evandro-teixeira/TCC---Otimiza-o-de-um-Refrigerador-Cycle-Defrost/Documentos/Imagens/2013-10-01_13-03-01_952.jpg

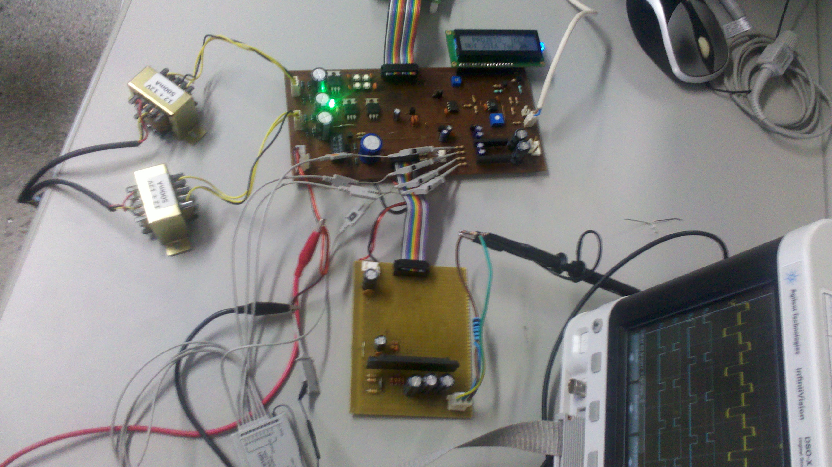
Documentos/Imagens/2013-10-01_13-03-01_952.jpg
