evandro-teixeira/TCC---Otimiza-o-de-um-Refrigerador-Cycle-Defrost/Documentos/Imagens/2013-10-01_13-02-46_918.jpg

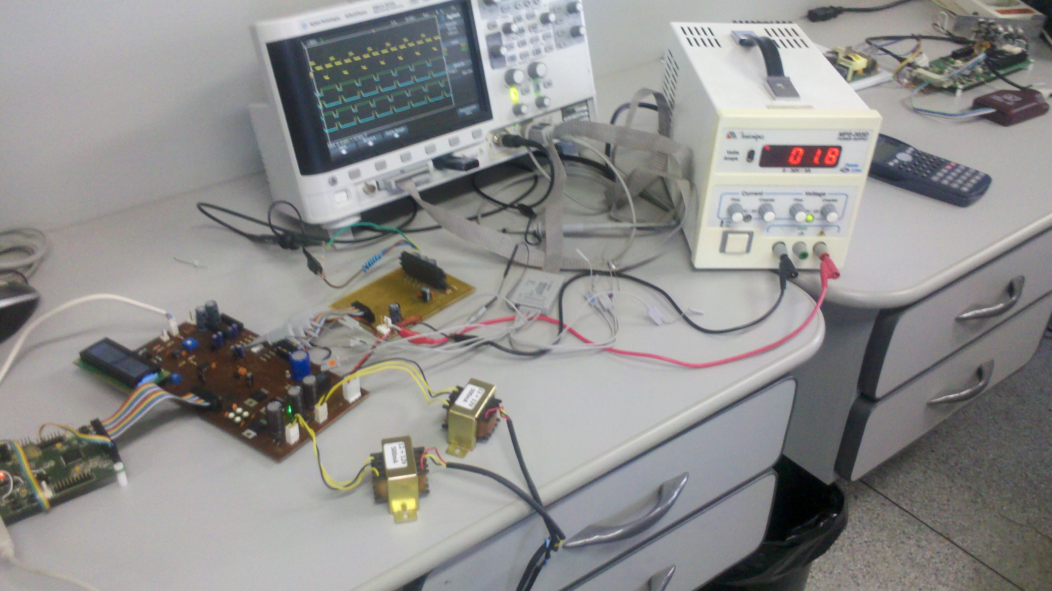
Documentos/Imagens/2013-10-01_13-02-46_918.jpg
