evandro-teixeira/TCC---Otimiza-o-de-um-Refrigerador-Cycle-Defrost/README.md

# TCC "Otimização de um Refrigerador Cycle Defrost"

Os refrigeradores domésticos convencionais apresentam um sistema de funcionamento singularmente simples, onde uma temperatura de operação é selecionada e um termostato é responsável por desativar o circuito elétrico de alimentação do motor do compressor, no momento em que essa temperatura é atingida internamente. Após o aumento da temperatura interna do refrigerador, novamente o compressor é acionado refrigerando seu interior até a temperatura selecionada, gerando um ciclo.

Apesar de esse sistema ser funcional, o mesmo apresenta algumas características negativas. Entre elas está o alto consumo de energia elétrica proveniente dos picos de corrente oriundos do acionamento do compressor.

Esse Trabalho de Conclusão de Curso propõe implementar um sistema de controle mais eficiente para o funcionamento do refrigerador através de um hardware e um software desenvolvidos para minimizar os picos de corrente do compressor, controlando sua partida e determinado sua velocidade de rotação pelo monitoramento da temperatura interna do refrigerador.

Em seguida através de testes, pretende-se comprovar o objetivo do projeto: verificar se há redução no consumo de energia com o novo sistema empregado.

Atualmente, apenas os refrigeradores de alto custo possuem esse sistema de controle. Entretanto ele será introduzido no refrigerador Cycle Defrost, um modelo de refrigerador mais simples e de baixo custo.

O trabalho de Conclusão de Curso realizado por:

EvandroTeixeira, Gerson Cezar Stein Junior, Guilherme Martino.

Orientado pelo Professor Marcus Vinícius Ataíde
