evandro-teixeira/TCC---Otimiza-o-de-um-Refrigerador-Cycle-Defrost/Documentos/Apresentação_TCC.pdf.pdf

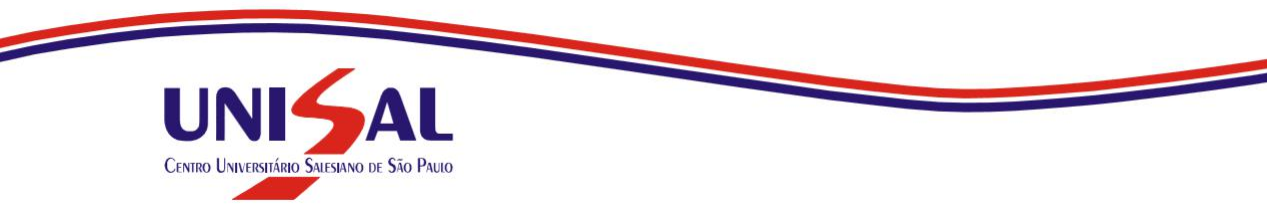
[picture p14: figure]

## Otimização de um Refrigerador Cycle Defrost

UNIVERSIDADE SALESIANA DE SÃO PAULO ENGENHARIA ELÉTRICA

Orientador: Professor Marcus Vinícius Ataíde

Evandro Luis Silva Teixeira Gerson Cezar Stein Junior
Guilherme Martino

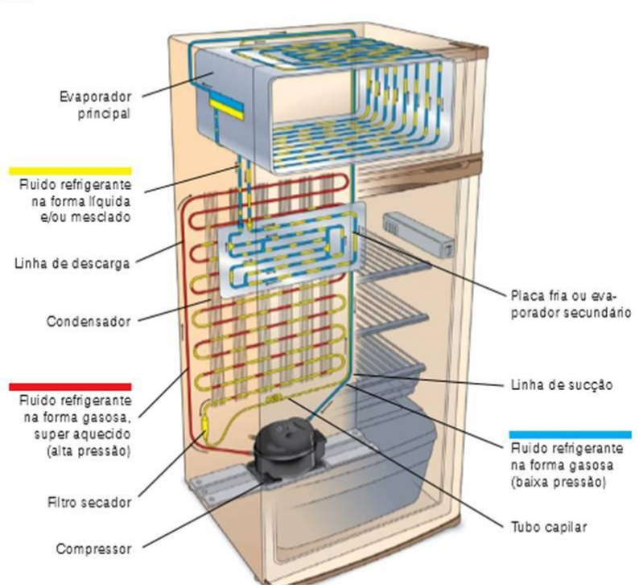
[picture p15: figure]

## Introdução

Funcionamento
do
Refrigerador

## Objetivos

SISTEMA ON-OFF

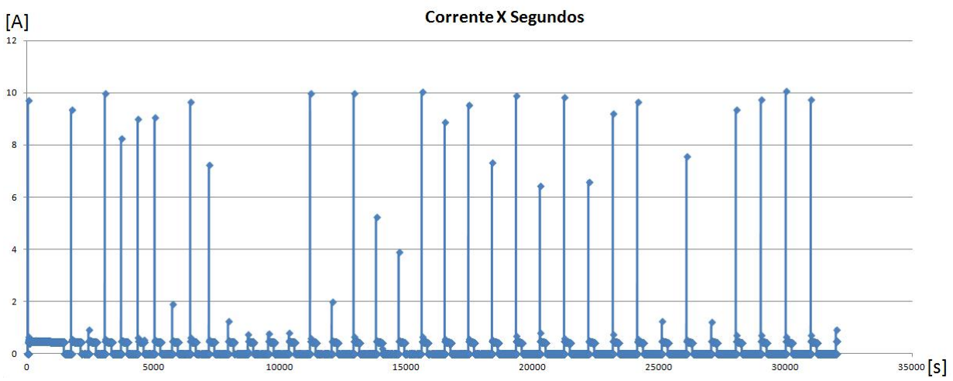
[picture p16: figure]

## Objetivos

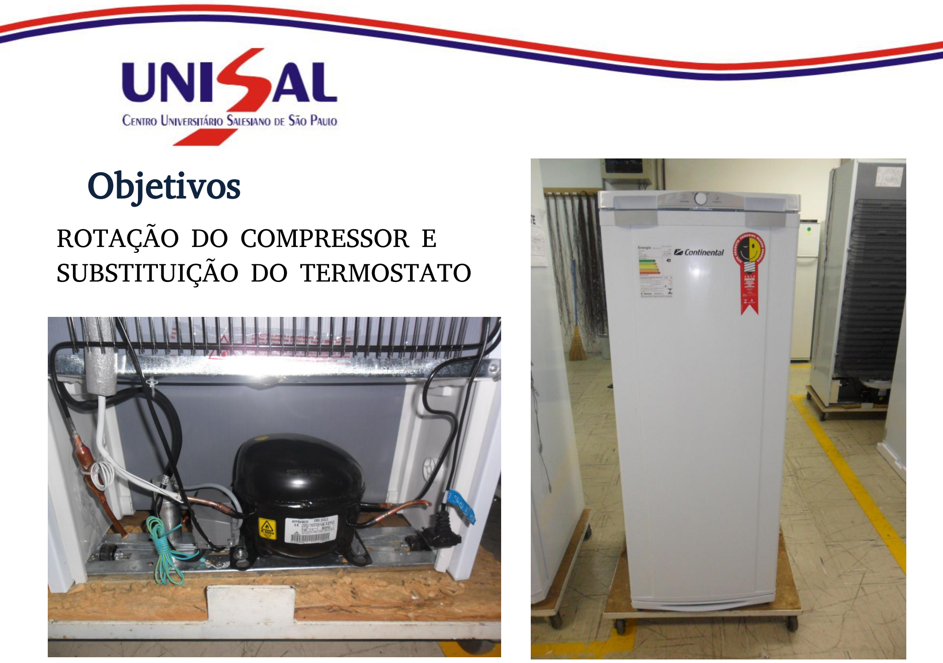
[picture p17: page 4]

ROTAÇÃO DO COMPRESSOR E
SUBSTITUIÇÃO DO TERMOSTATO

## Objetivos

O Projeto:
- Desenvolver o Hardware
- Desenvolver o Software

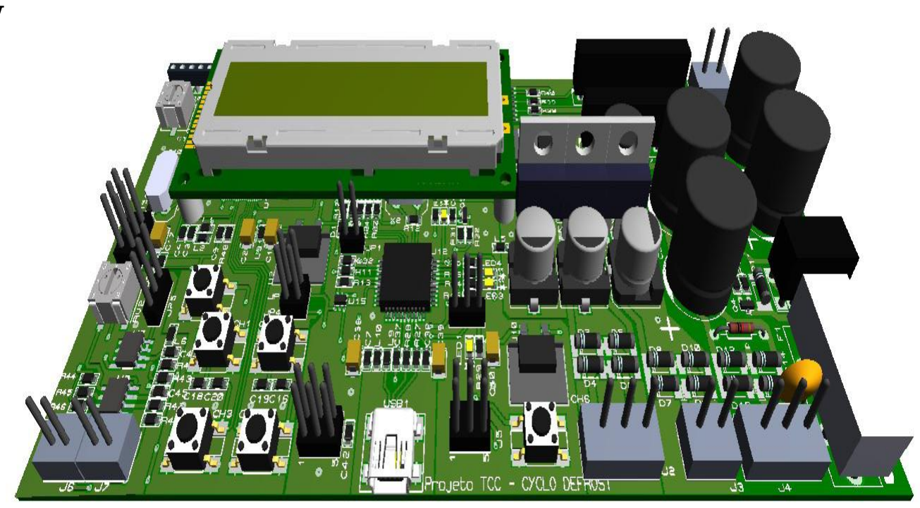
[picture p18: figure]

## Testes Iniciais

MAPEAMENTO DAS TEMPERATURAS INTERNAS DO REFRIGERADOR

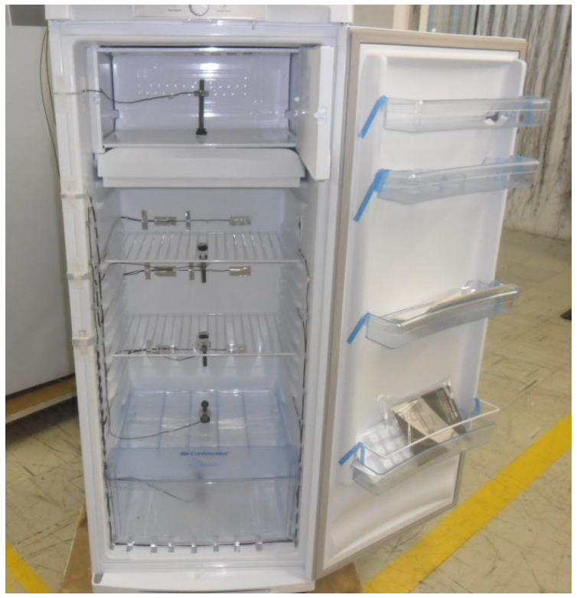
[picture p19: figure]

## Testes Iniciais

ENSAIO DE CONSUMO ENERGÉTICO

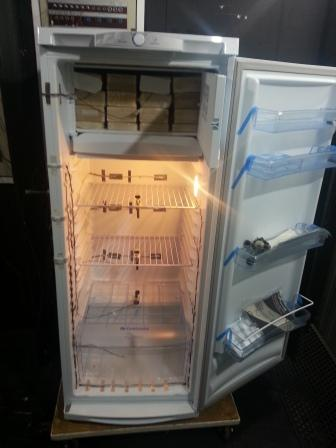
[picture p20: figure]

## Desenvolvimento do Hardware

- Microcontrolador
MCF51MM256
CodeFire 32 bit, 50MHz, ADC 16 bit, DAC 12 bit, 4 Timer PWM
MC9S08JM60

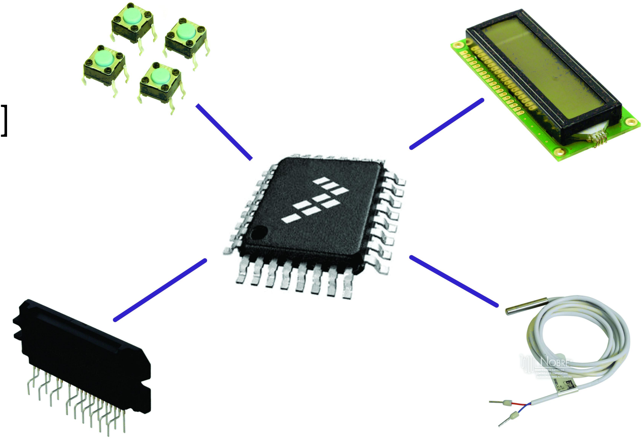
[picture p21: figure]

Circuito de Gravação e Depuração - OSBDM

- IHM
Display LCD 16x2, 4 Push-Button
- Transdutor de Temperatura
Divisor de Tensão, Buffer LT1013, Termistor NTC

## Desenvolvimento do Hardware

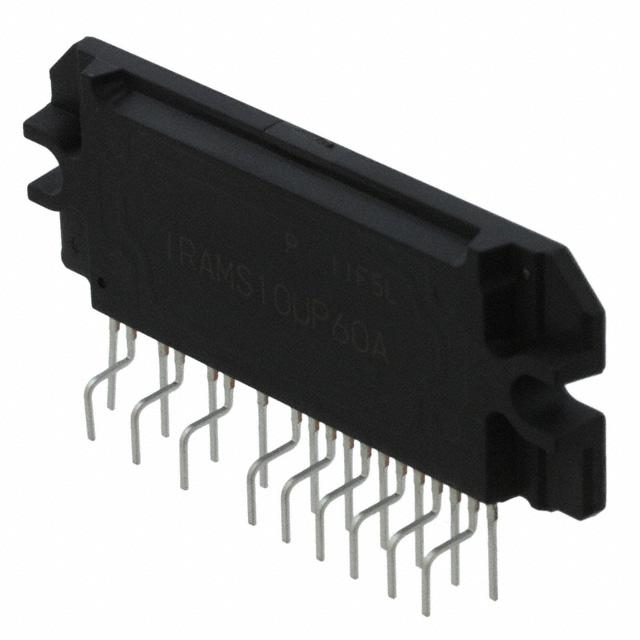
[picture p22: figure]

## Inversor de Frequência

- FSB50250
500V RMS, 1A, 1500V RMS
- IRAMS10P60A
600V RSM, 10A, 2000V RMS
- IR3101
500V RMS, 1.6A, 1500V RMS

## Desenvolvimento do Software

## - Linguagem C - IDE CodeWarrior

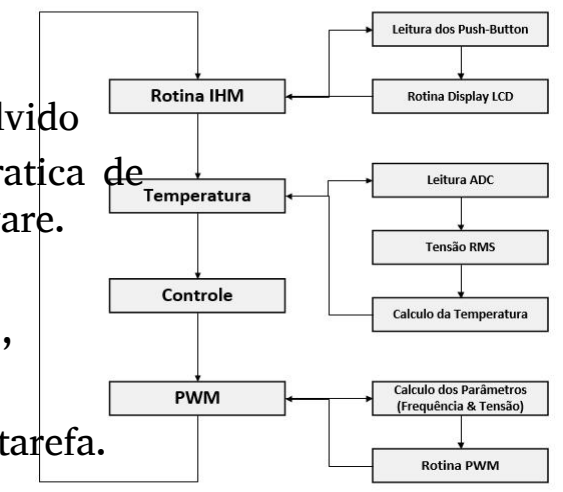
[picture p23: figure]

## - O software foi desenvolvido utilizando as boas pratica de

desenvolvimento Firmware. • Maquina de estado,

- Estruturado em Modulo,

## onde cada modulo é

responsável por uma tarefa.

## Resultados

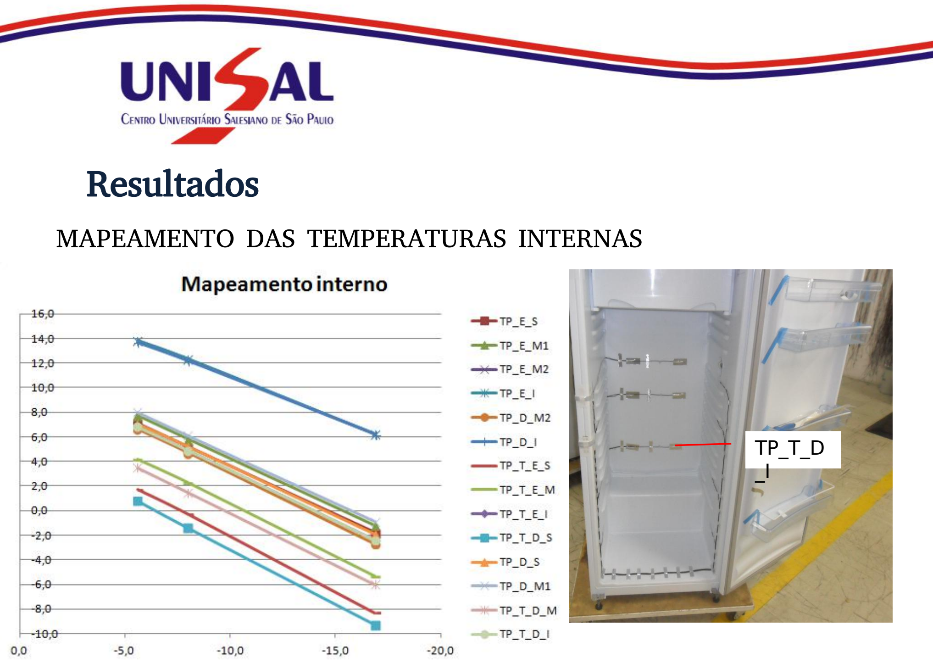
[picture p24: page 11]

MAPEAMENTO DAS TEMPERATURAS INTERNAS

TP_T_D
_I

Resultados CONSUMO | #2 | #3

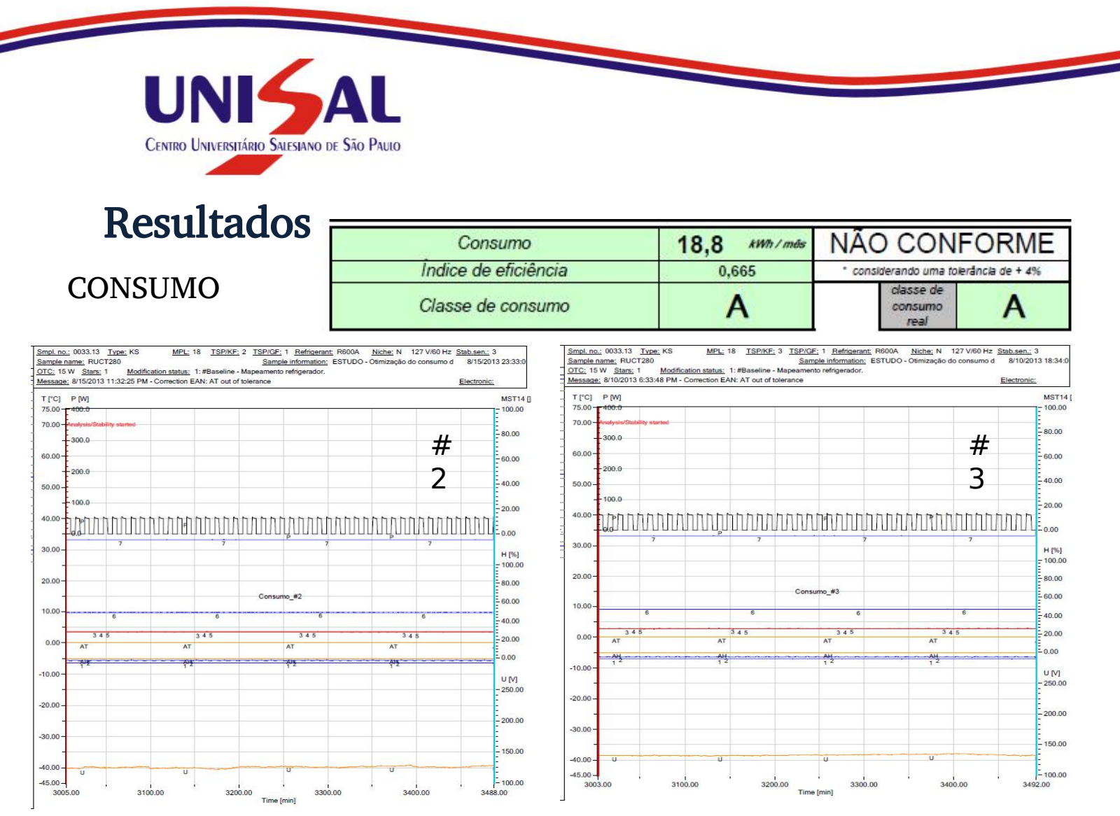
[picture p25: page 12]

## Resultados

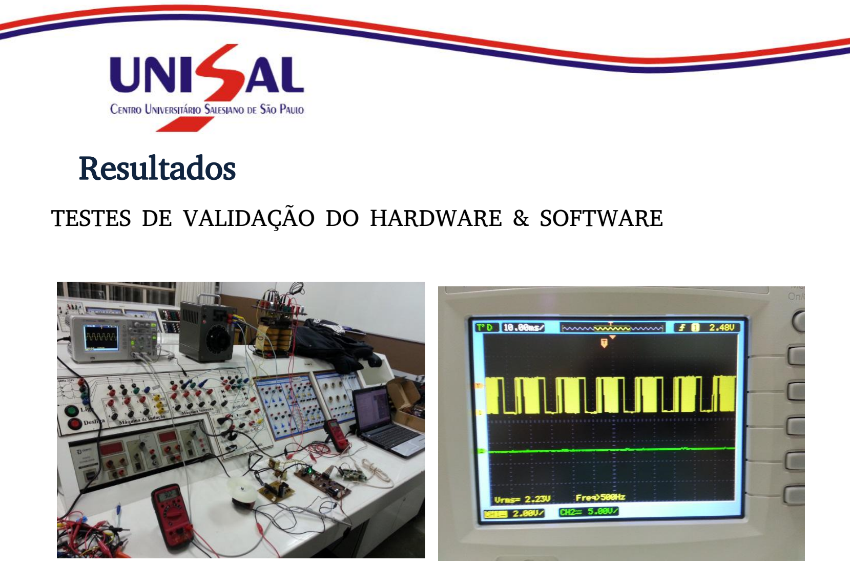
[picture p26: page 13]

TESTES DE VALIDAÇÃO DO HARDWARE & SOFTWARE

## Resultados

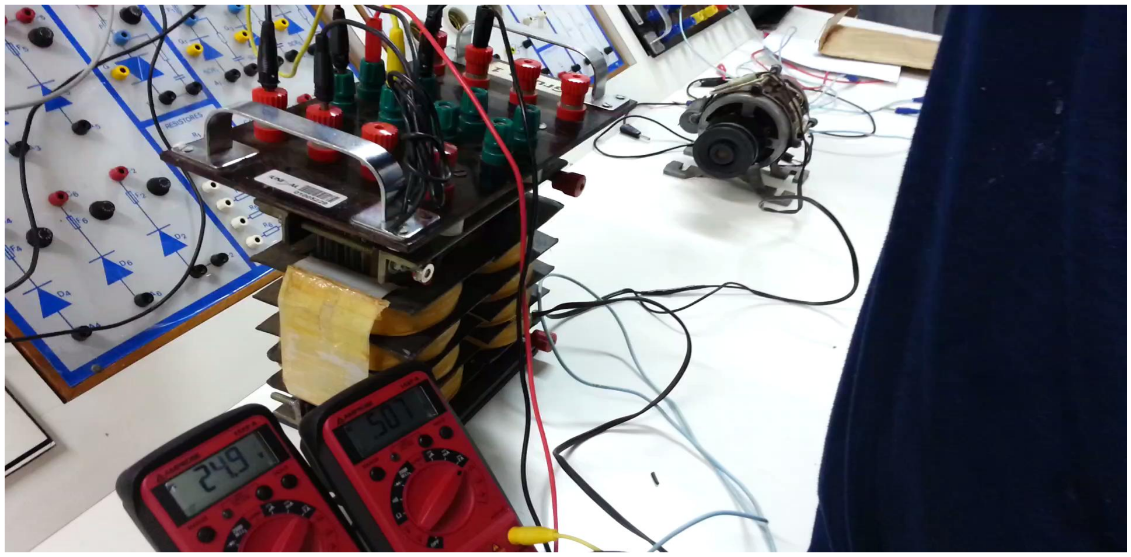
[picture p27: figure]

## Conclusão

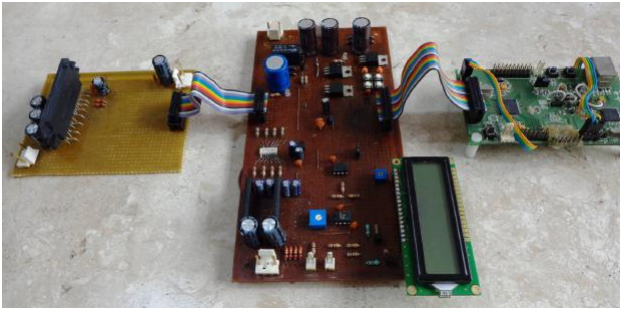
[picture p28: figure]

CUSTO DOS COMPONENTES: $56,73 PARA LOTE DE 1000 UNIDADES

## Agradecimentos

- Primeiramente a Deus por nos ter dado condição e sabedoria. • As empresas MABE, BIOSENSOR e o Centro Universitário

Salesiano de São Paulo nos ter fornecido por todo o material necessário para o desenvolvimento do projeto. Muito Obrigado!
