evandro-teixeira/TCC---Otimiza-o-de-um-Refrigerador-Cycle-Defrost/Documentos/Imagens/2013-10-01_13-02-21_155.jpg

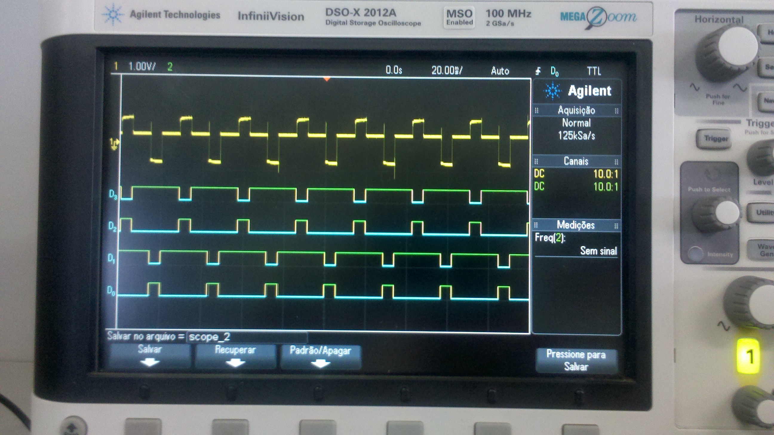
Documentos/Imagens/2013-10-01_13-02-21_155.jpg
