evandro-teixeira/TCC---Otimiza-o-de-um-Refrigerador-Cycle-Defrost/Documentos/Imagens/INV0.jpg

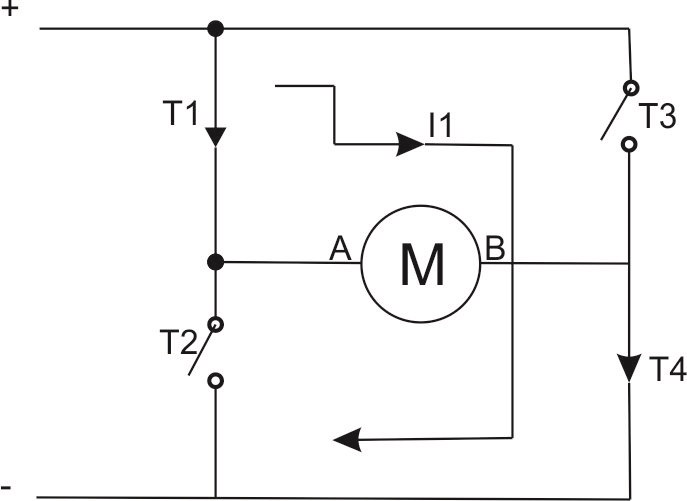
Documentos/Imagens/INV0.jpg
