evandro-teixeira/TCC---Otimiza-o-de-um-Refrigerador-Cycle-Defrost/Documentos/Imagens/INV1.jpg

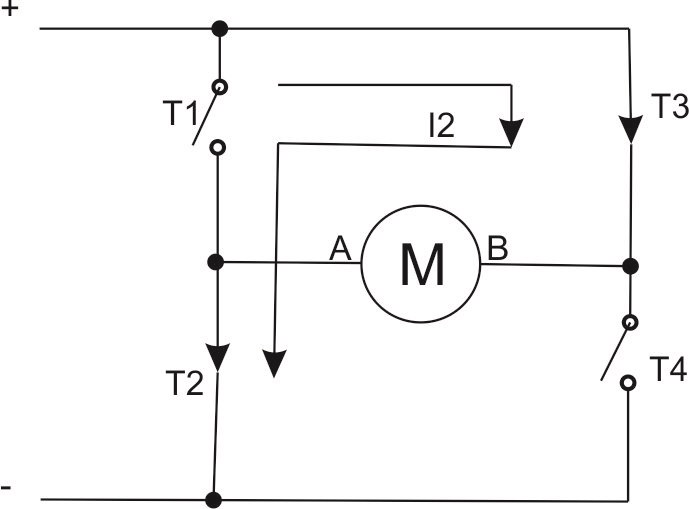
Documentos/Imagens/INV1.jpg
