evandro-teixeira/TCC---Otimiza-o-de-um-Refrigerador-Cycle-Defrost/Documentos/Imagens/INV2.jpg

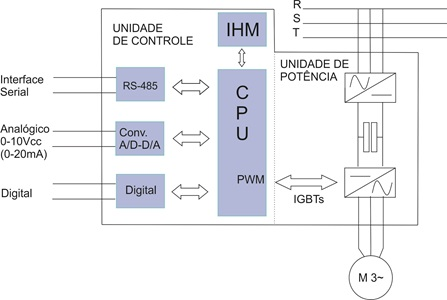
Documentos/Imagens/INV2.jpg
