evandro-teixeira/TCC---Otimiza-o-de-um-Refrigerador-Cycle-Defrost/Documentos/Imagens/INV4.jpg

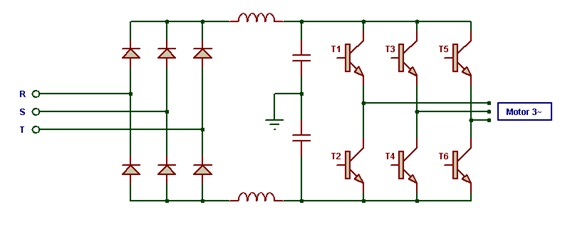
Documentos/Imagens/INV4.jpg
