evandro-teixeira/TCC---Otimiza-o-de-um-Refrigerador-Cycle-Defrost/Documentos/Imagens/INV5.jpg

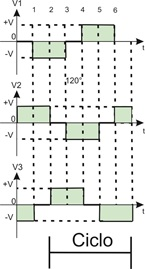
Documentos/Imagens/INV5.jpg
