evandro-teixeira/TCC---Otimiza-o-de-um-Refrigerador-Cycle-Defrost/Documentos/Imagens/INV6.jpg

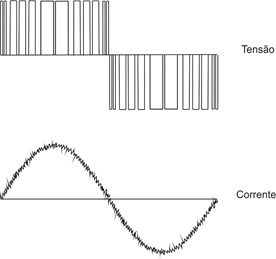
Documentos/Imagens/INV6.jpg
