evandro-teixeira/TCC---Otimiza-o-de-um-Refrigerador-Cycle-Defrost/Documentos/Imagens/INV7.jpg

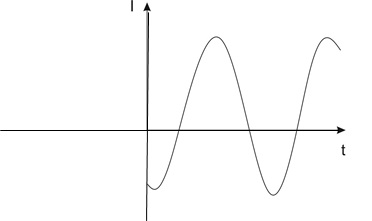
Documentos/Imagens/INV7.jpg
