evandro-teixeira/TCC---Otimiza-o-de-um-Refrigerador-Cycle-Defrost/Documentos/Imagens/INV8.jpg

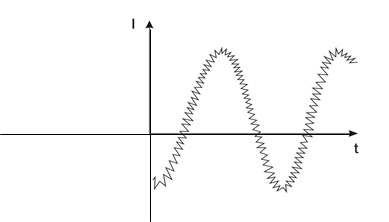
Documentos/Imagens/INV8.jpg
