evandro-teixeira/TCC---Otimiza-o-de-um-Refrigerador-Cycle-Defrost/Documentos/Imagens/INV9.jpg

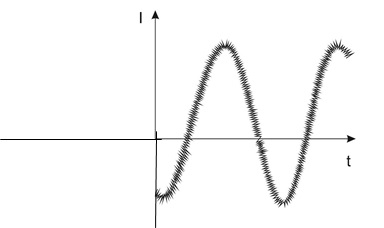
Documentos/Imagens/INV9.jpg
