evandro-teixeira/TCC---Otimiza-o-de-um-Refrigerador-Cycle-Defrost/Documentos/Imagens/scope_0.png

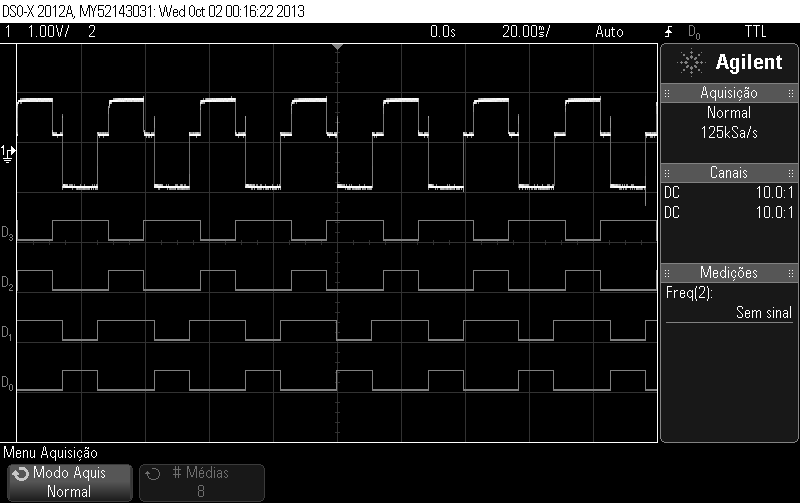
Documentos/Imagens/scope_0.png
