evandro-teixeira/TCC---Otimiza-o-de-um-Refrigerador-Cycle-Defrost/Documentos/Imagens/scope_1.png

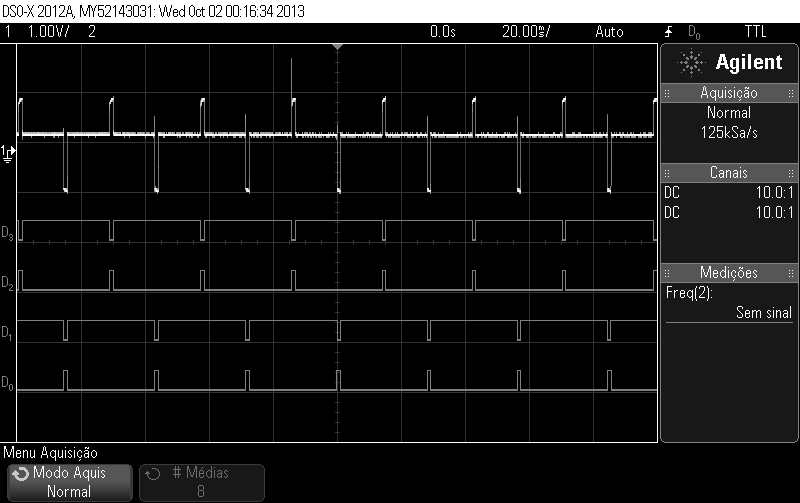
Documentos/Imagens/scope_1.png
