evandro-teixeira/TCC---Otimiza-o-de-um-Refrigerador-Cycle-Defrost/(list of files, cad)

Other CAD files:
Firmware/ProjetoTCC/FLASH/Sources/main_c.obj
Firmware/ProjetoTCC/FLASH/Project_Settings/Startup_Code/startcf_c.obj
Firmware/ProjetoTCC/FLASH/Sources/Timer_c.obj
Firmware/ProjetoTCC/FLASH/Sources/aplicacao_c.obj
Firmware/ProjetoTCC/FLASH/Sources/LCD_c.obj
Firmware/ProjetoTCC/FLASH/Sources/Controle_LCD_c.obj
Firmware/ProjetoTCC/FLASH/Sources/MCUinit_c.obj
