evandro-teixeira/TCC---Otimiza-o-de-um-Refrigerador-Cycle-Defrost/Hardware/hardware_tcc.PDF

L1

L2

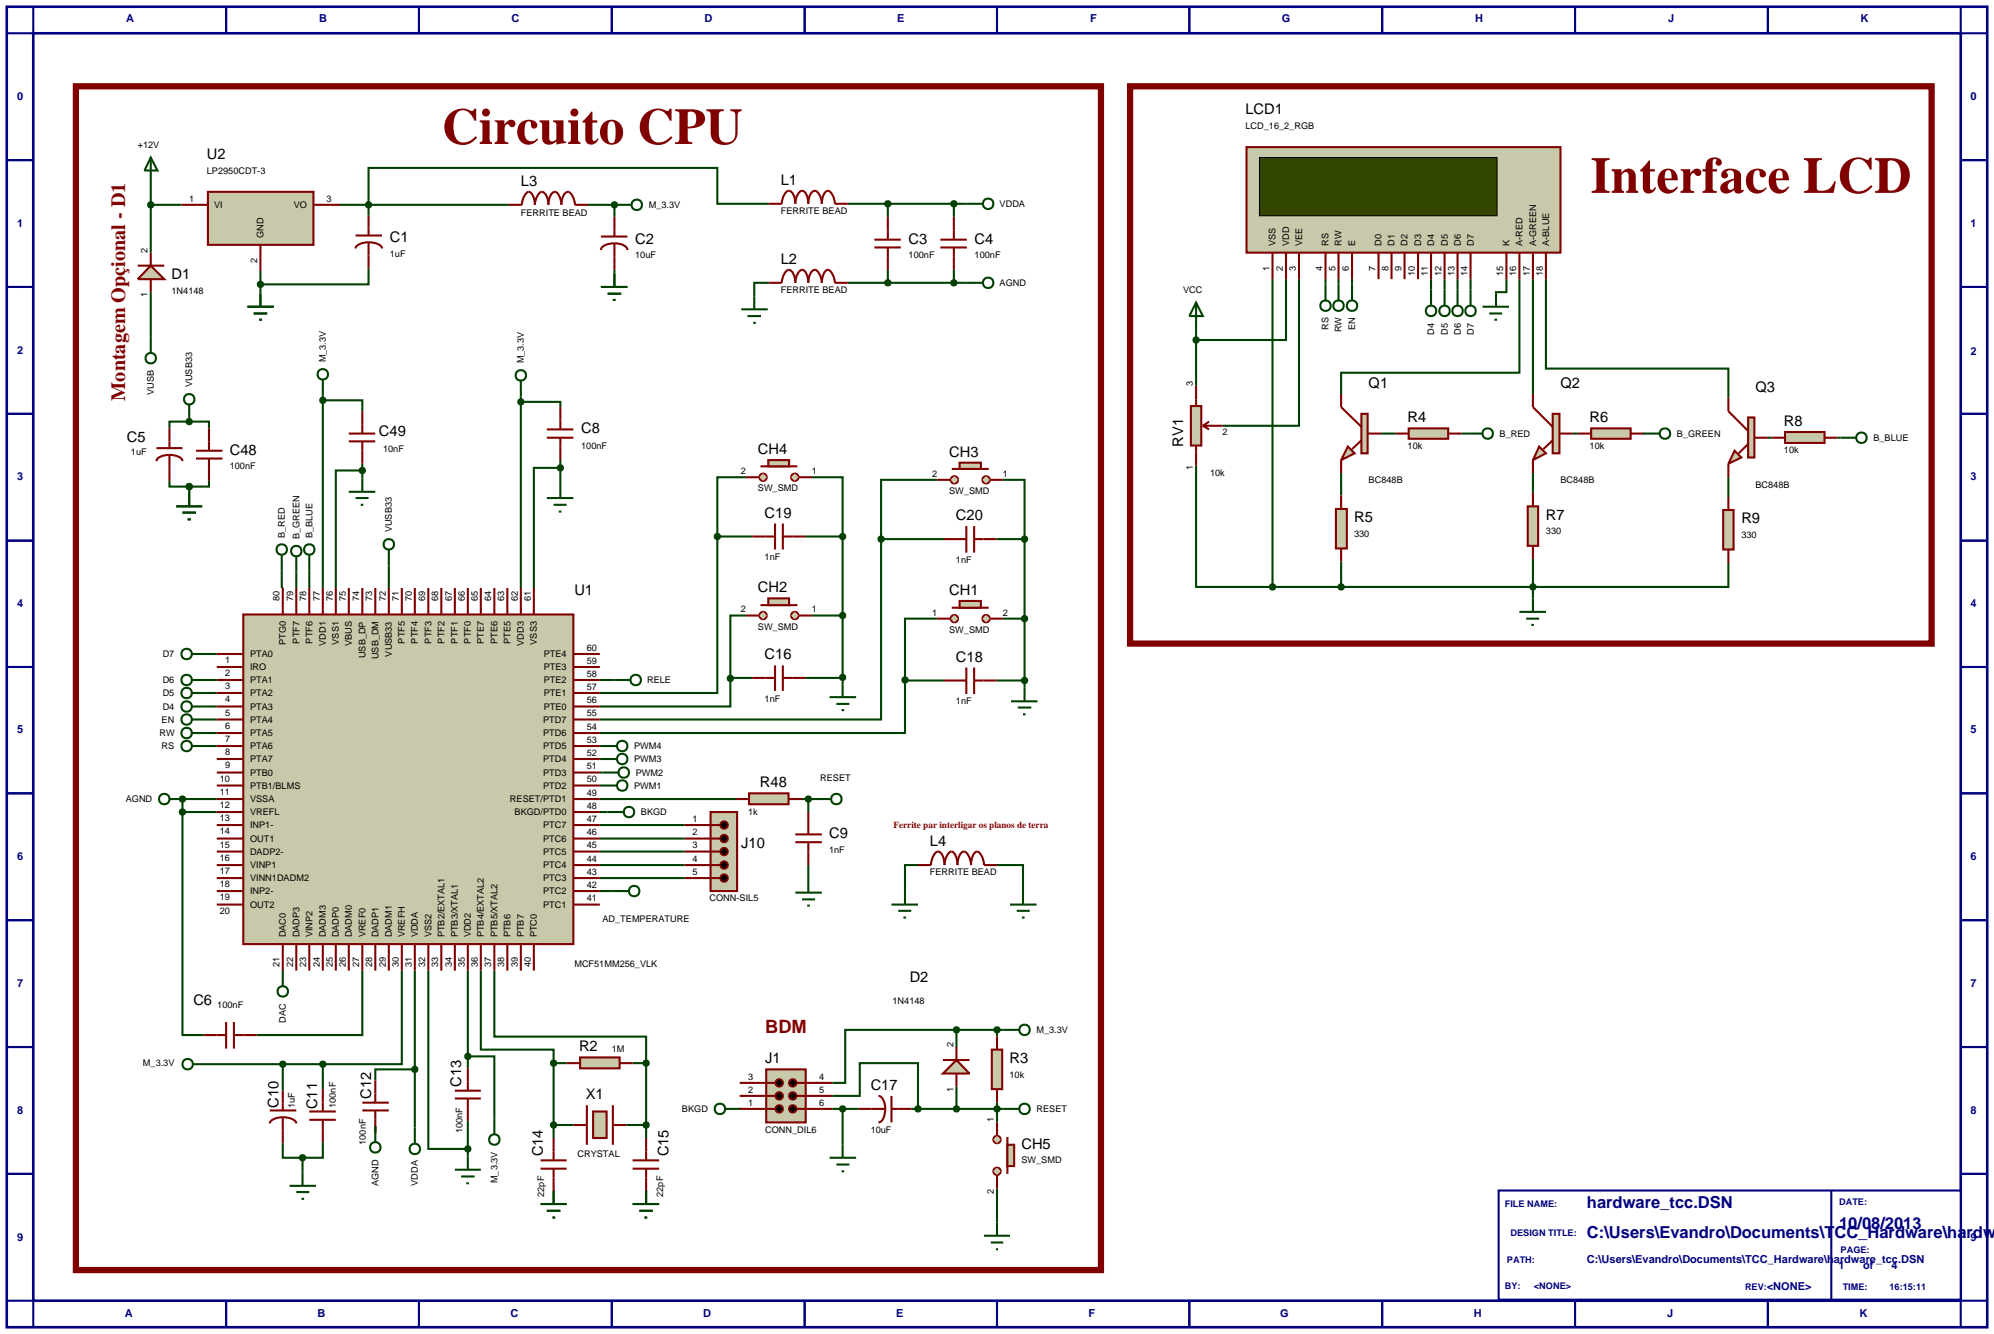
[picture p42: page 1]

FILE NAME:
DESIGN TITLE: C:\Users\Evandro\Documents\TCC_Hardware\hardware_tcc.DSN

TR2

U4

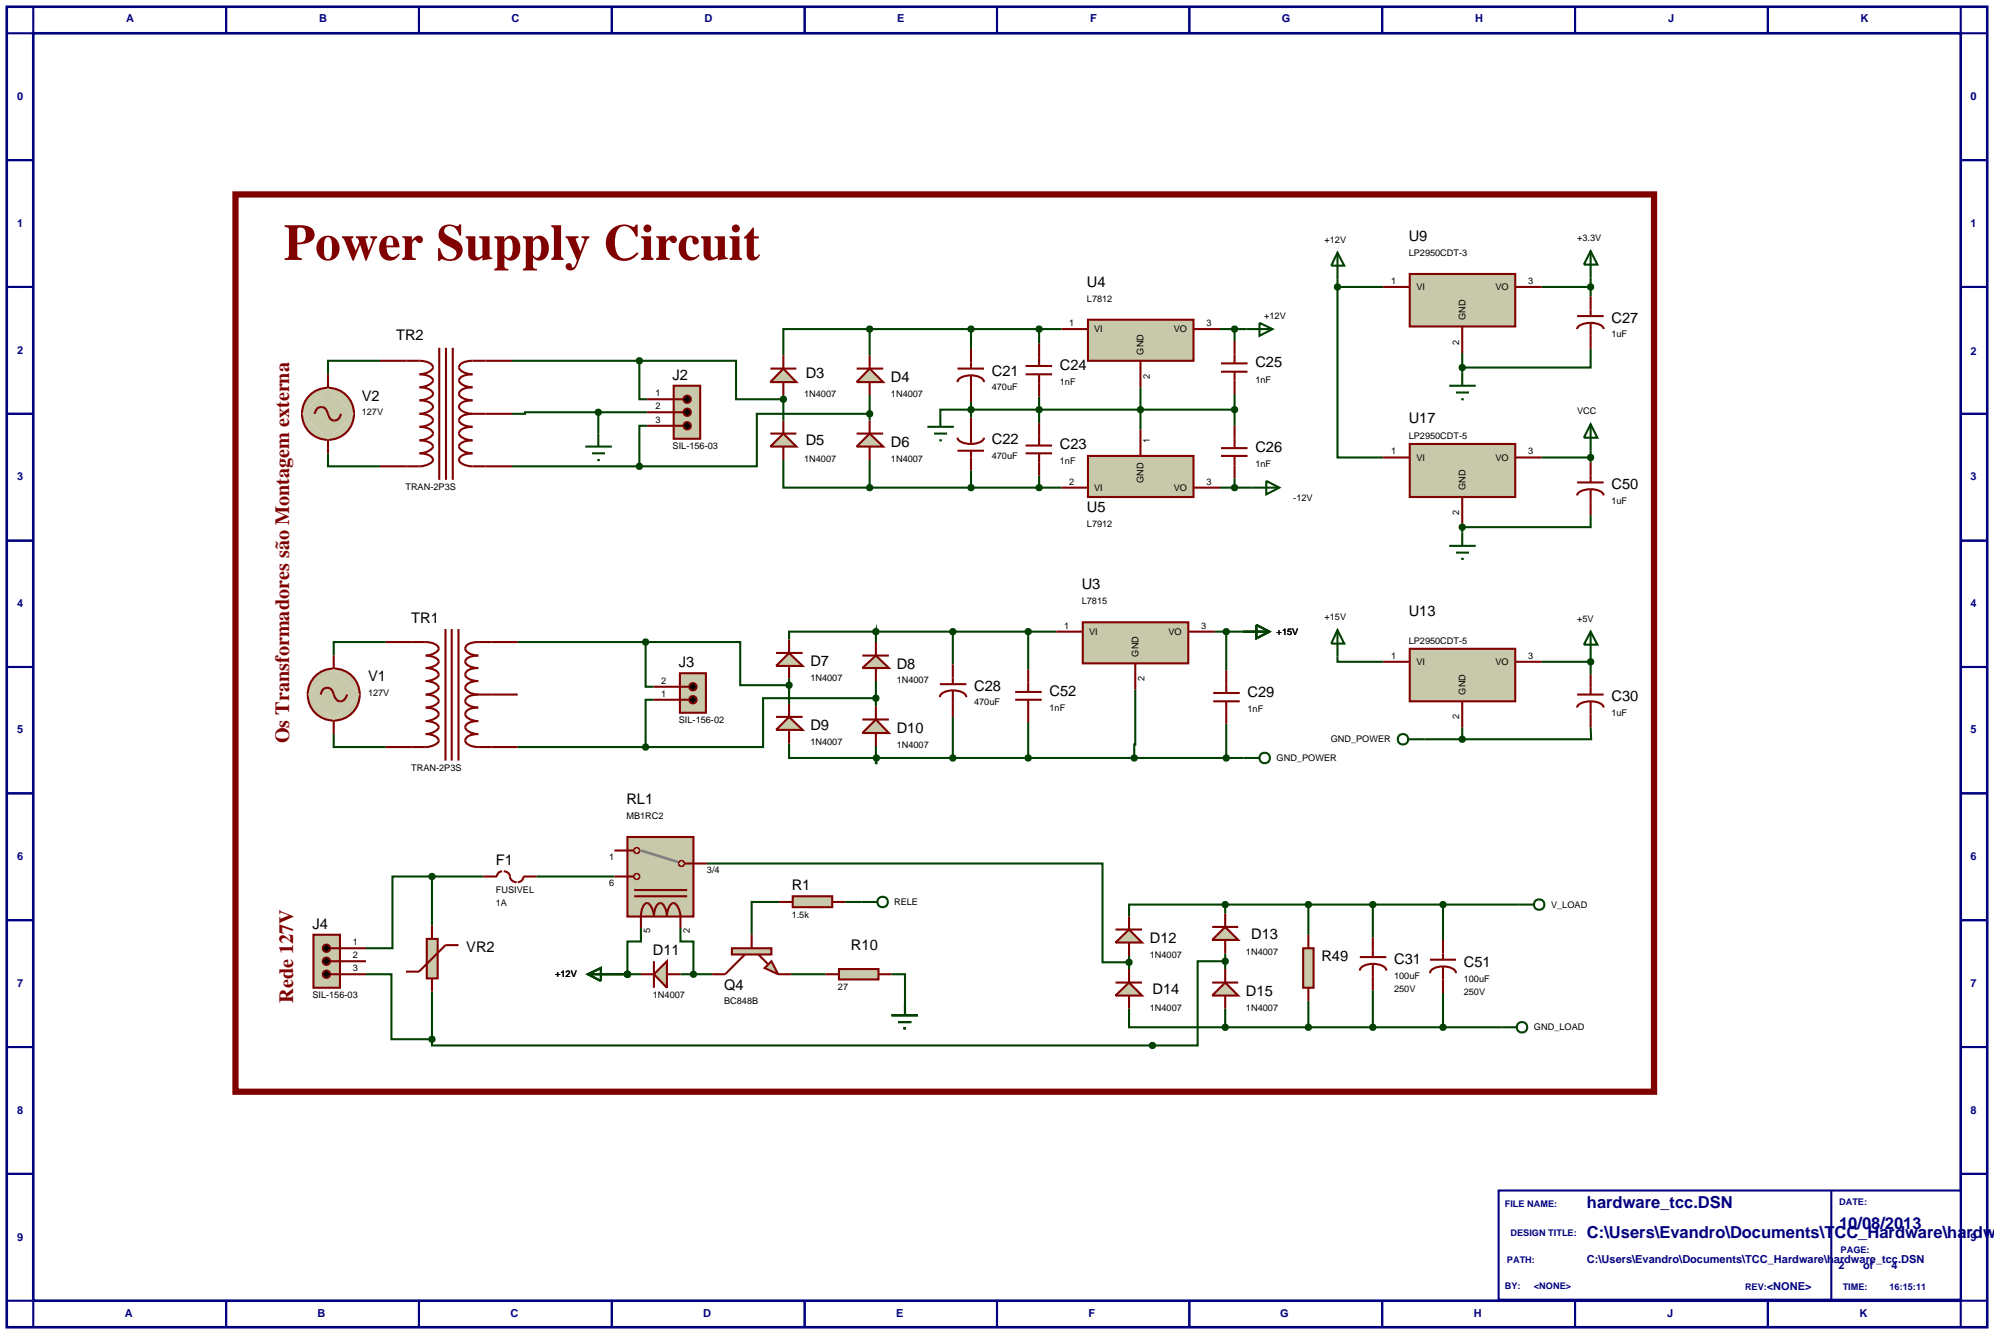
[picture p43: page 2]

Os Transformadores são Montagem externa Rede 127V

X2

C34

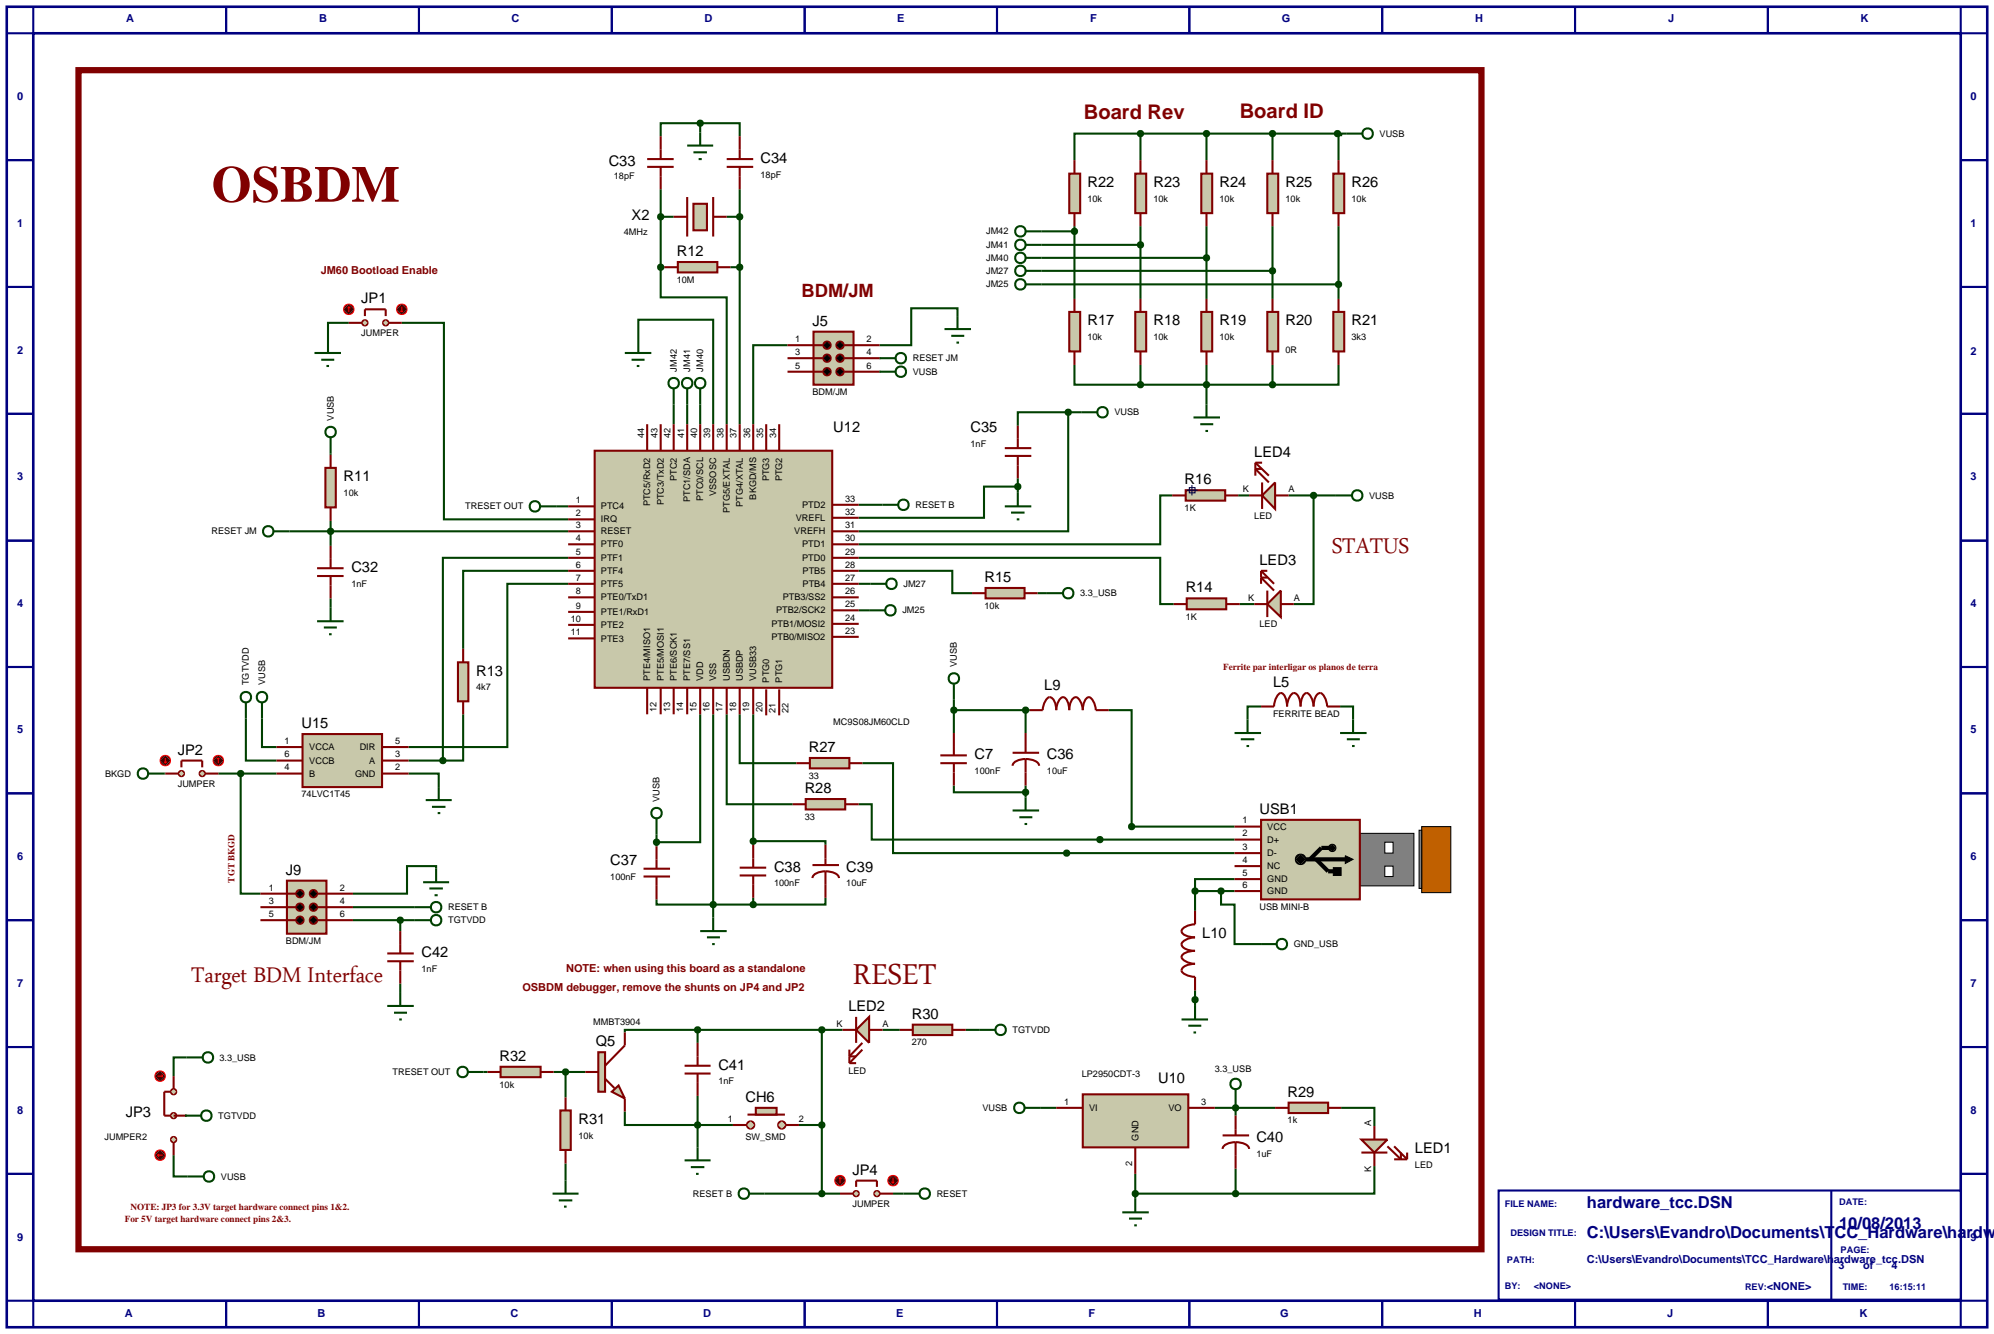
[picture p44: page 3]

Ferrite par interligar os planos de terra

NOTE: when using this board as a standalone

NOTE: JP3 for 3.3V target hardware connect pins 1&2.
For 5V target hardware connect pins 2&3.

Q6

R33

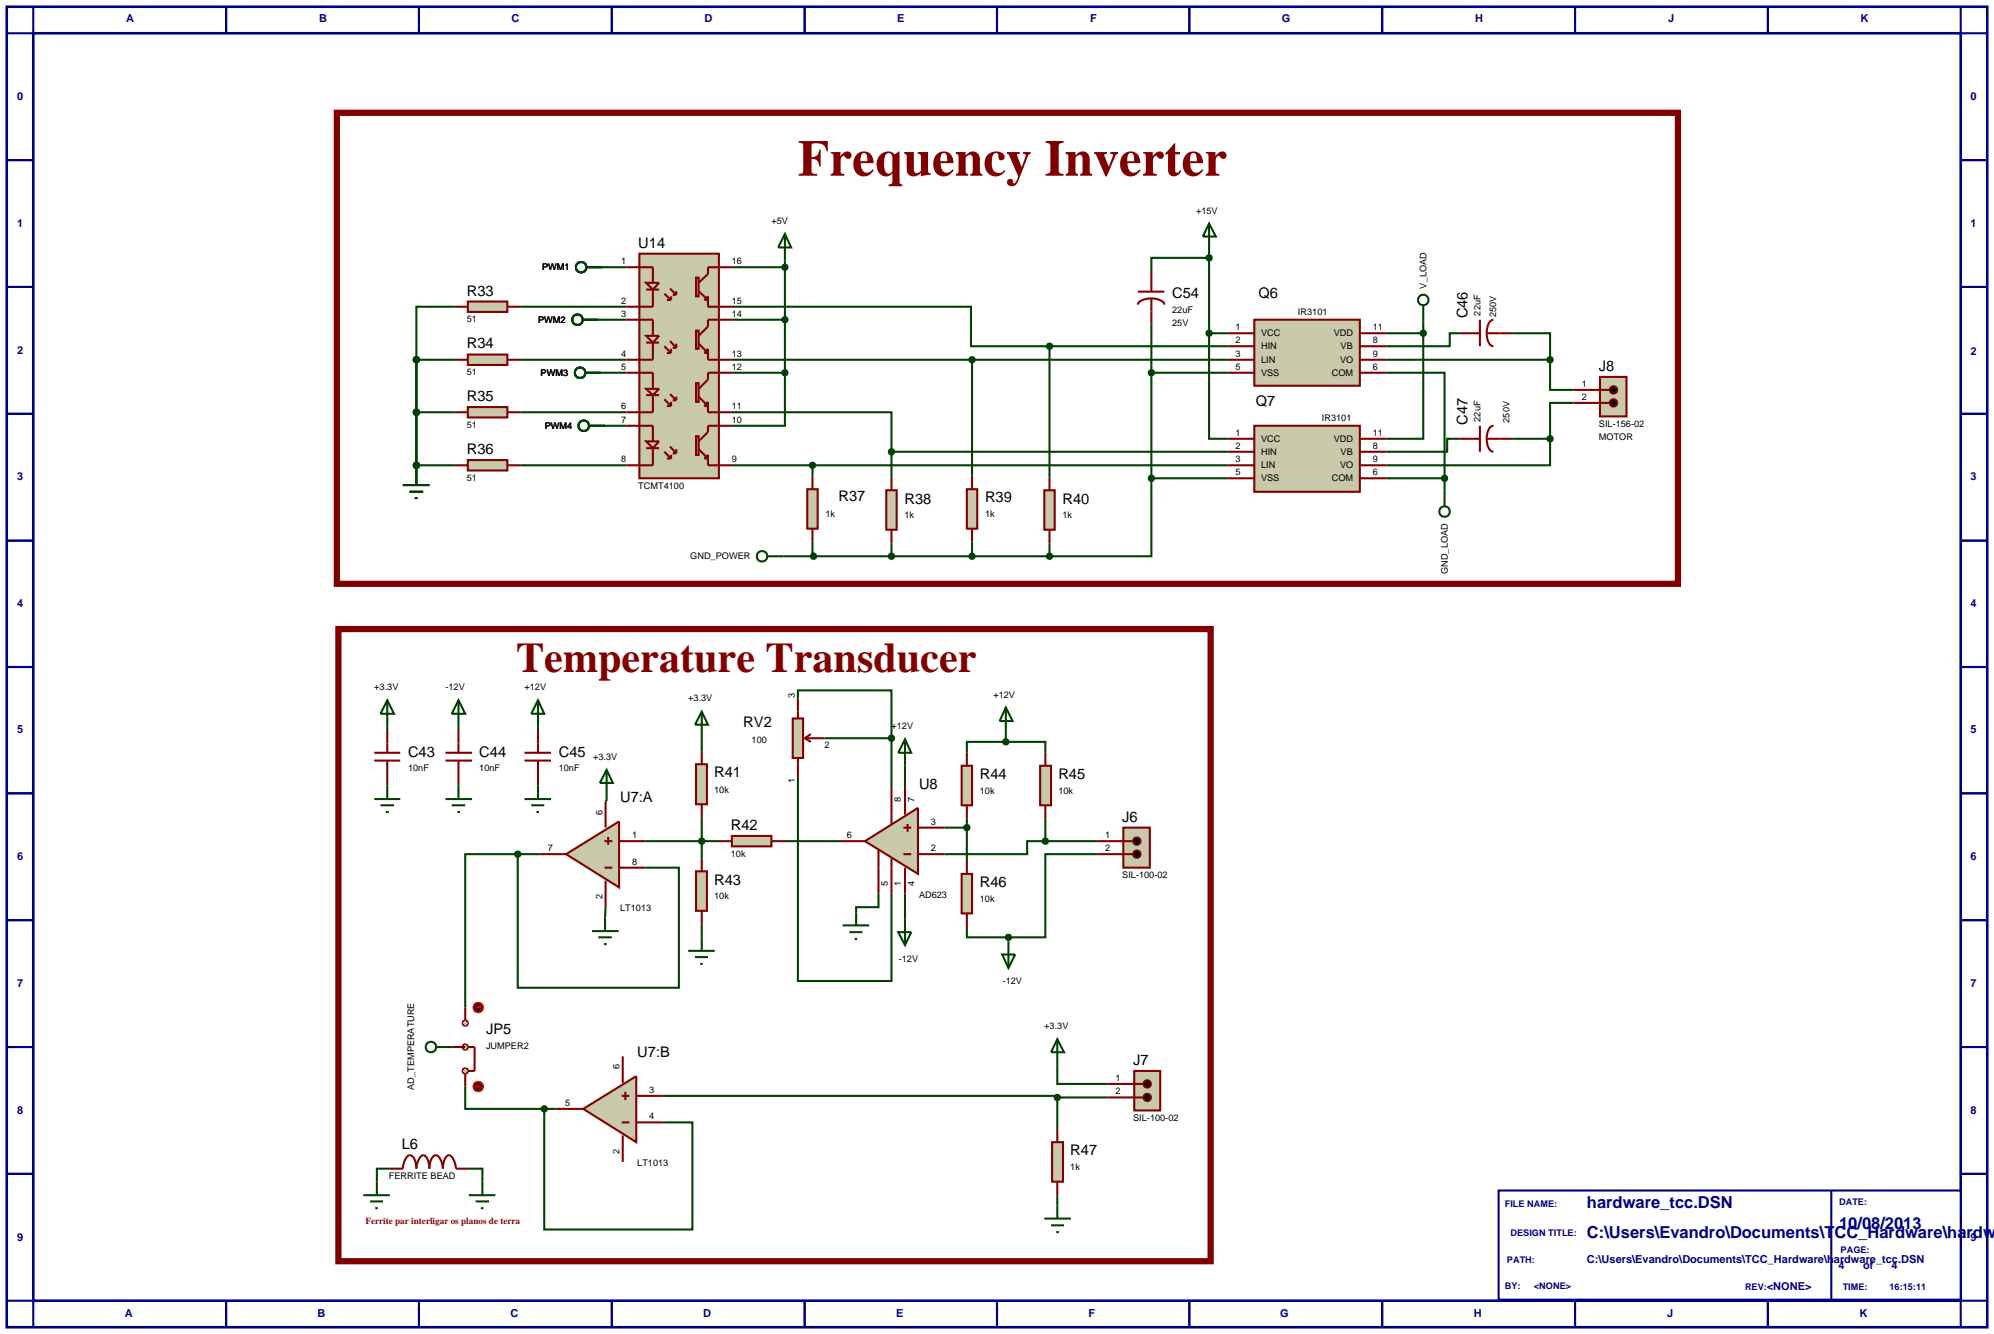
[picture p45: page 4]

Ferrite par interligar os planos de terra
