evandro-teixeira/TCC---Otimiza-o-de-um-Refrigerador-Cycle-Defrost/(list of files, drawings)

Other design files:
Hardware/hardware_tcc.DSN
Hardware/hardware_tcc.LYT
